Zaworek03/Line-Follower/KiCad/Dodatkowe elementy/1049/1049.step

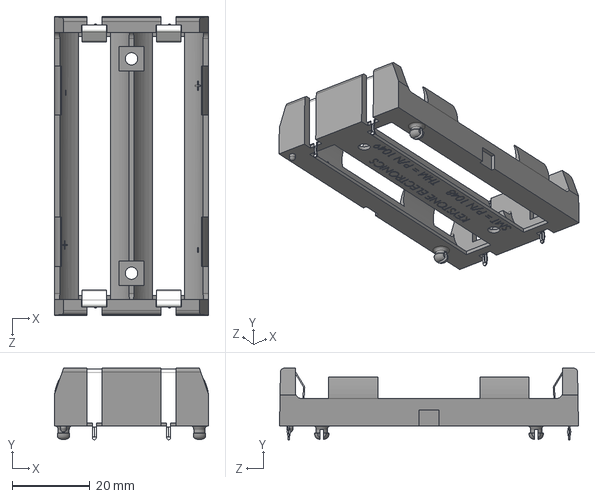
[picture p10: CAD file, 2025-11-26]
KiCad/Dodatkowe elementy/1049/1049.step
39.8 x 18.5 x 77.1 mm
