Zaworek03/Line-Follower/KiCad/Dodatkowe elementy/1N5819HW-7-F/1N5819HW-7-F.step

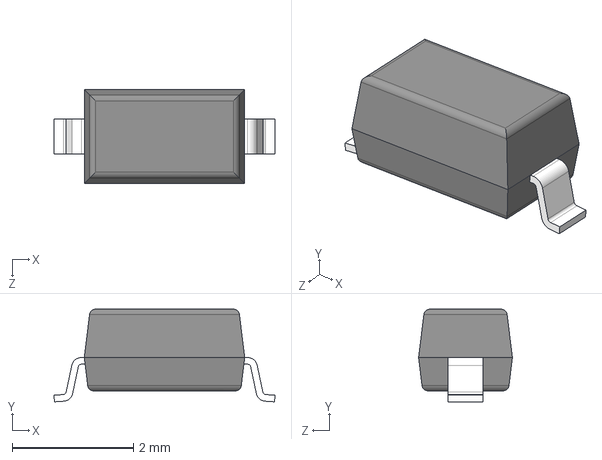
[picture p11: CAD file, 2025-11-26]
KiCad/Dodatkowe elementy/1N5819HW-7-F/1N5819HW-7-F.step
3.65 x 1.53 x 1.55 mm
