Zaworek03/Line-Follower/KiCad/Dodatkowe elementy/3362P-1-253LF-2/3362P-1-253LF.step

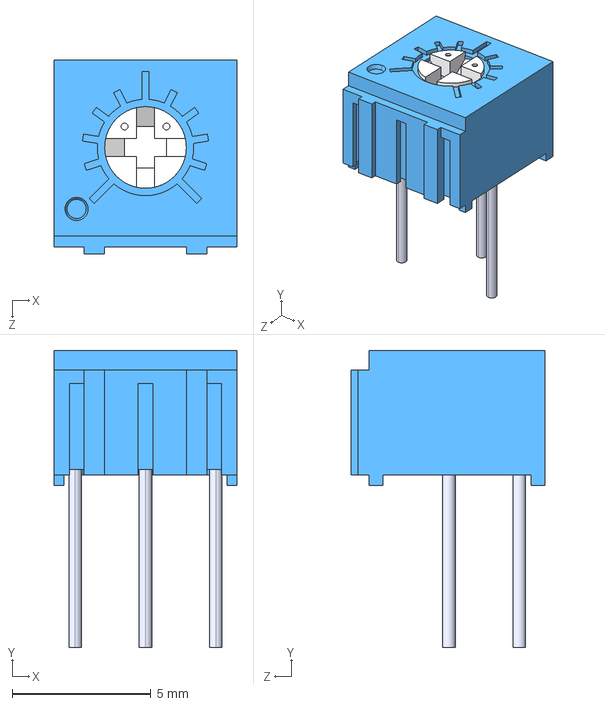
[picture p12: CAD file, 2025-11-26]
KiCad/Dodatkowe elementy/3362P-1-253LF-2/3362P-1-253LF.step
6.60 x 10.7 x 6.99 mm
