Zaworek03/Line-Follower/KiCad/Dodatkowe elementy/500SSP1S1M2REA/500SSP1S1M2REA.step

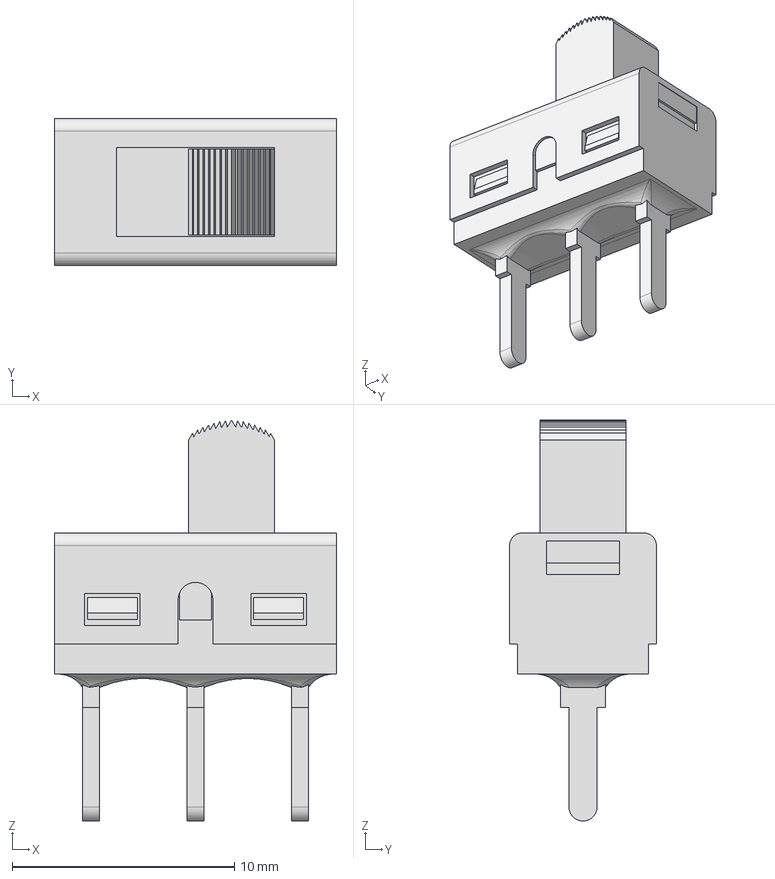
[picture p13: CAD file, 2025-11-26]
KiCad/Dodatkowe elementy/500SSP1S1M2REA/500SSP1S1M2REA.step
12.7 x 6.60 x 18.0 mm
