Zaworek03/Line-Follower/KiCad/Dodatkowe elementy/B2B-XH-A/B2B-XH-A.step

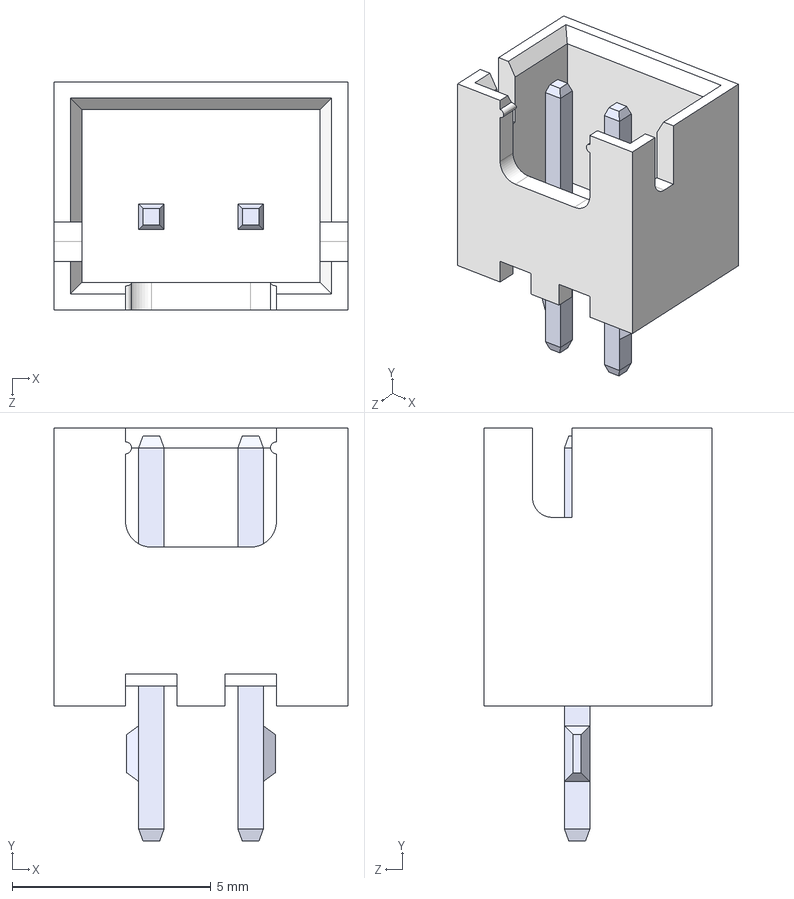
[picture p14: CAD file, 2025-11-26]
KiCad/Dodatkowe elementy/B2B-XH-A/B2B-XH-A.step
7.40 x 10.4 x 5.75 mm
