Zaworek03/Line-Follower/KiCad/Dodatkowe elementy/DM-OLED096-636/DM-OLED096-636.step

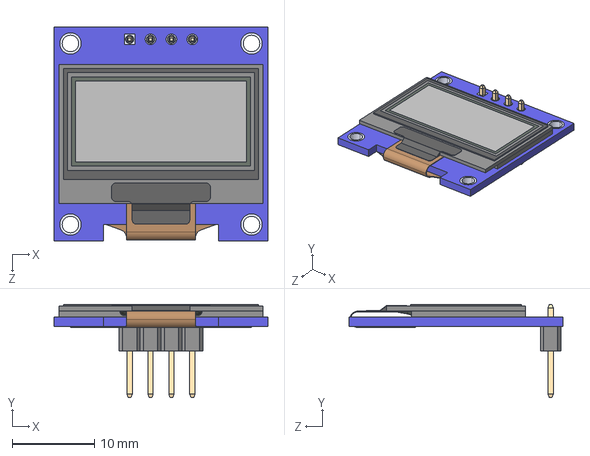
[picture p15: CAD file, 2025-11-26]
KiCad/Dodatkowe elementy/DM-OLED096-636/DM-OLED096-636.step
26.0 x 11.3 x 26.0 mm
DM-OLED096-636_Module
DM-OLED096-636_Panel
