Zaworek03/Line-Follower/KiCad/Dodatkowe elementy/ESP32-S3-WROOM-1U-N16R8/ESP32-S3-WROOM-1U-N16R8.step

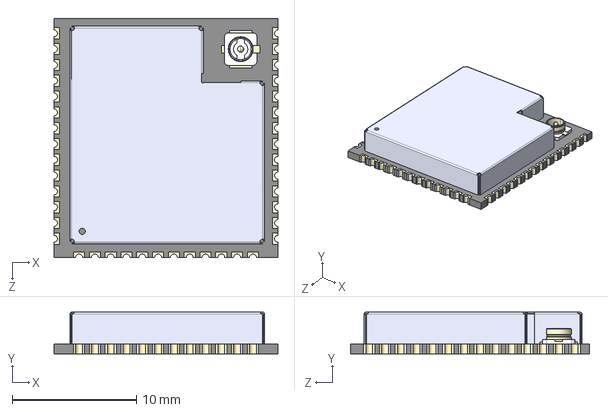
[picture p16: CAD file, 2025-11-26]
KiCad/Dodatkowe elementy/ESP32-S3-WROOM-1U-N16R8/ESP32-S3-WROOM-1U-N16R8.step
18.0 x 3.35 x 19.2 mm
