Zaworek03/Line-Follower/KiCad/Dodatkowe elementy/L298N/L298N.step

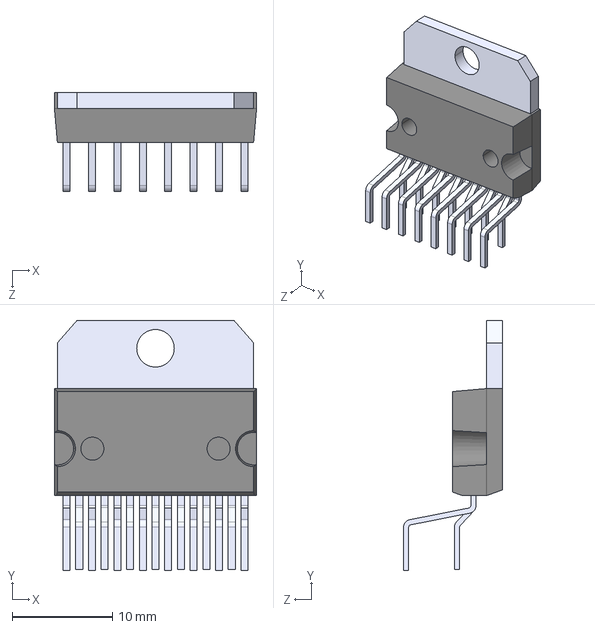
[picture p17: CAD file, 2025-11-26]
KiCad/Dodatkowe elementy/L298N/L298N.step
20.2 x 25.0 x 9.89 mm
