Zaworek03/Line-Follower/KiCad/Dodatkowe elementy/LESD5D5/LESD5D5.0CT1G.step

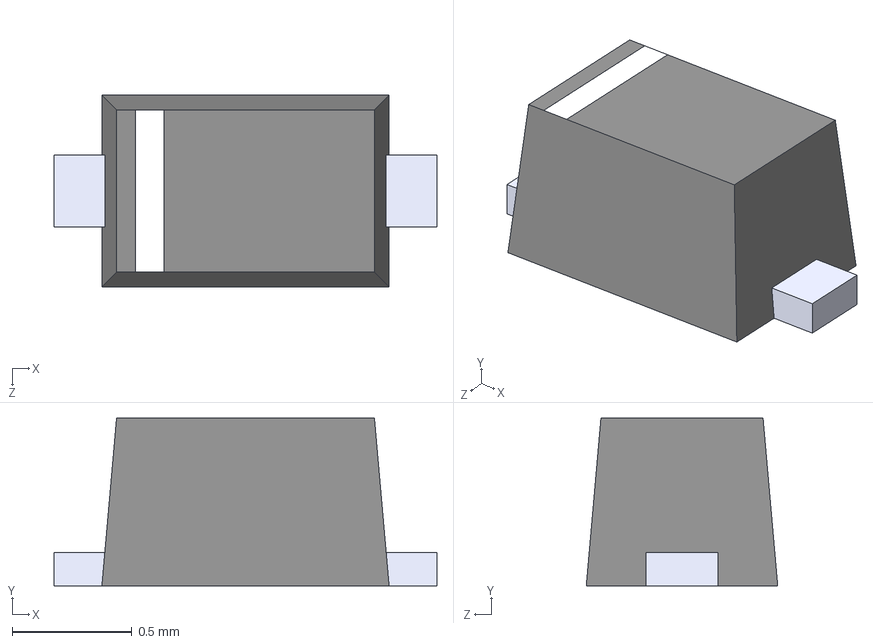
[picture p18: CAD file, 2025-11-26]
KiCad/Dodatkowe elementy/LESD5D5/LESD5D5.0CT1G.step
1.60 x 0.7 x 0.8 mm
