Zaworek03/Line-Follower/KiCad/Dodatkowe elementy/SS34/SS34.step

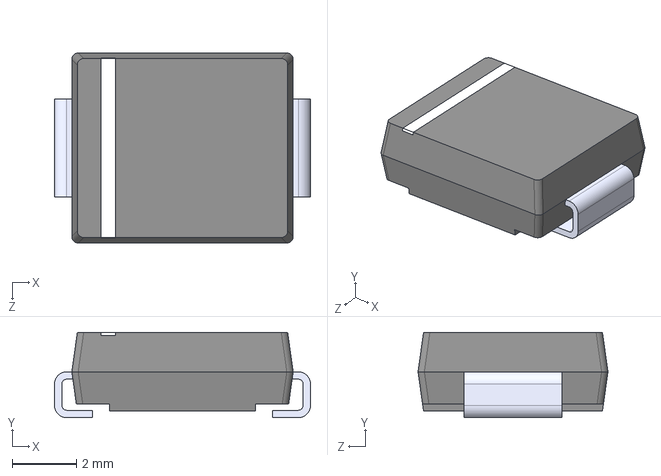
[picture p19: CAD file, 2025-11-26]
KiCad/Dodatkowe elementy/SS34/SS34.step
7.95 x 2.65 x 5.90 mm
