Zaworek03/Line-Follower/KiCad/Dodatkowe elementy/TB6612FNG/TB6612FNG.step

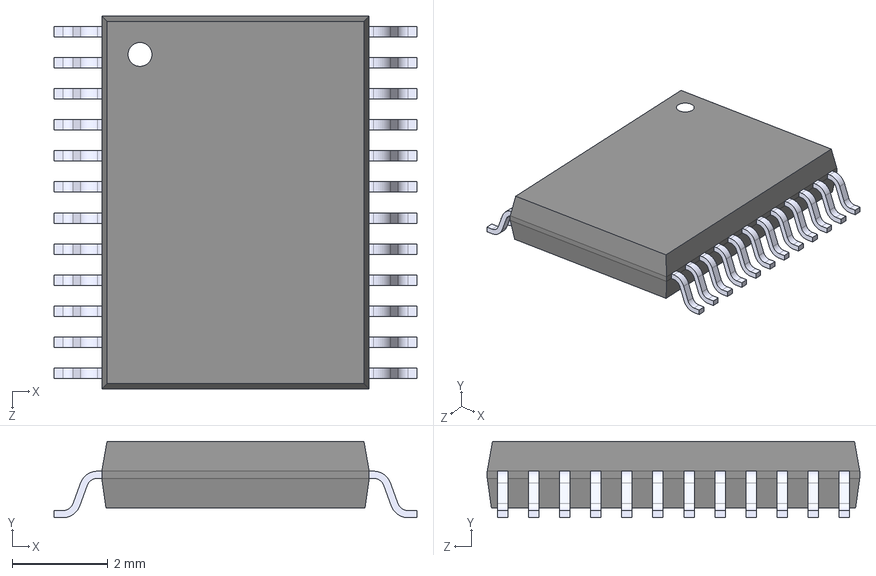
[picture p20: CAD file, 2025-11-26]
KiCad/Dodatkowe elementy/TB6612FNG/TB6612FNG.step
7.60 x 1.60 x 7.80 mm
