Zaworek03/Line-Follower/KiCad/Dodatkowe elementy/TCRT5000L/TCRT5000L.step

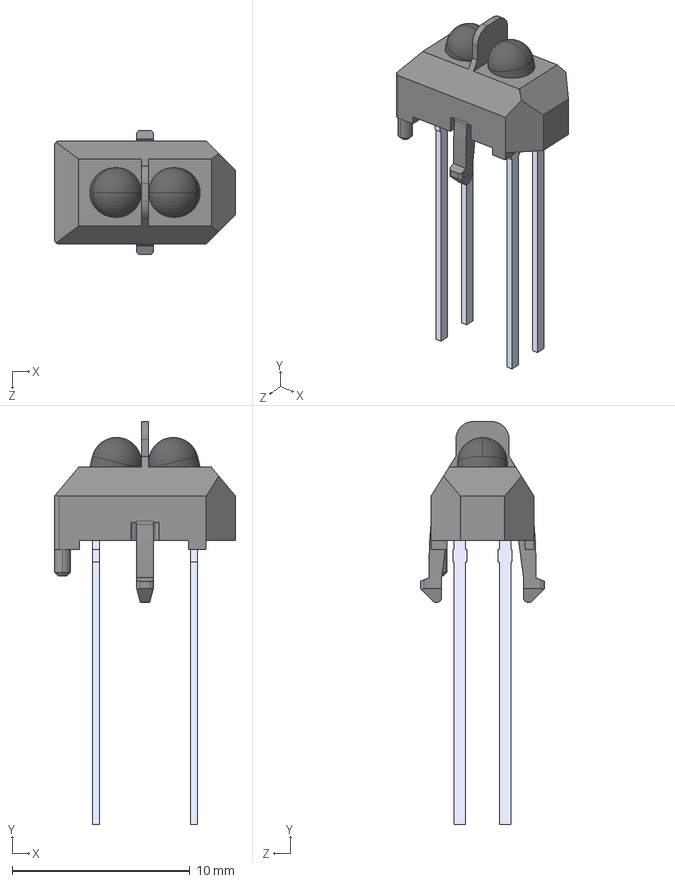
[picture p21: CAD file, 2025-11-26]
KiCad/Dodatkowe elementy/TCRT5000L/TCRT5000L.step
10.2 x 22.7 x 7.00 mm
