Zaworek03/Line-Follower/KiCad/Dodatkowe elementy/TS-1088-AR02016/TS-1088-AR02016.step

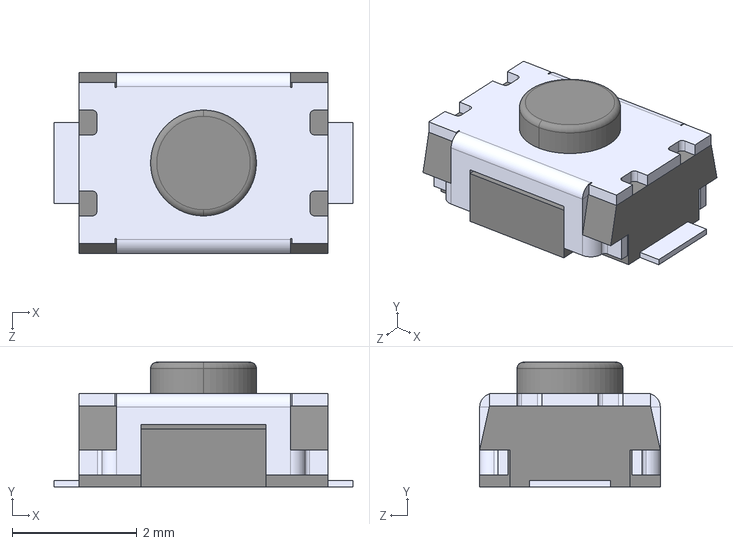
[picture p22: CAD file, 2025-11-26]
KiCad/Dodatkowe elementy/TS-1088-AR02016/TS-1088-AR02016.step
4.80 x 2.00 x 2.90 mm
