Zaworek03/Line-Follower/KiCad/Dodatkowe elementy/TS04-66-70-BK-260-SMT/TS04-66-70-BK-260-SMT.step

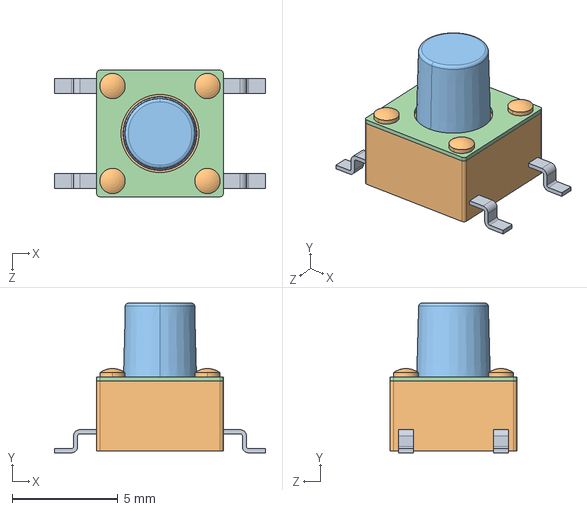
[picture p23: CAD file, 2025-11-26]
KiCad/Dodatkowe elementy/TS04-66-70-BK-260-SMT/TS04-66-70-BK-260-SMT.step
10.0 x 7.10 x 6.00 mm
