Zaworek03/Line-Follower/KiCad/gerber/Line follower-drl_map.dxf

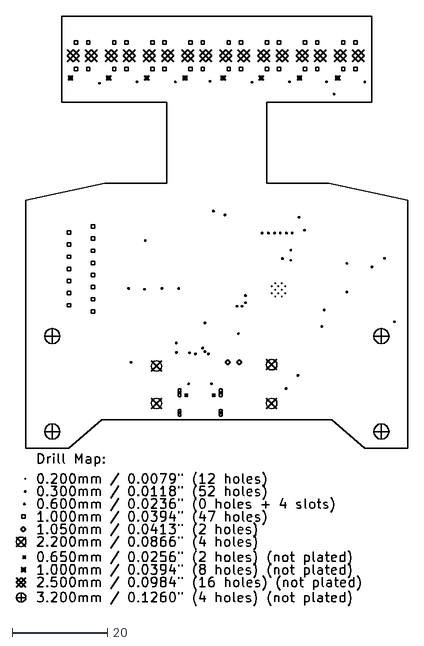
[picture p24: CAD file, 2025-11-26]
KiCad/gerber/Line follower-drl_map.dxf
82.0 x 123.5
