Zaworek03/Line-Follower/KiCad/Line follower.step

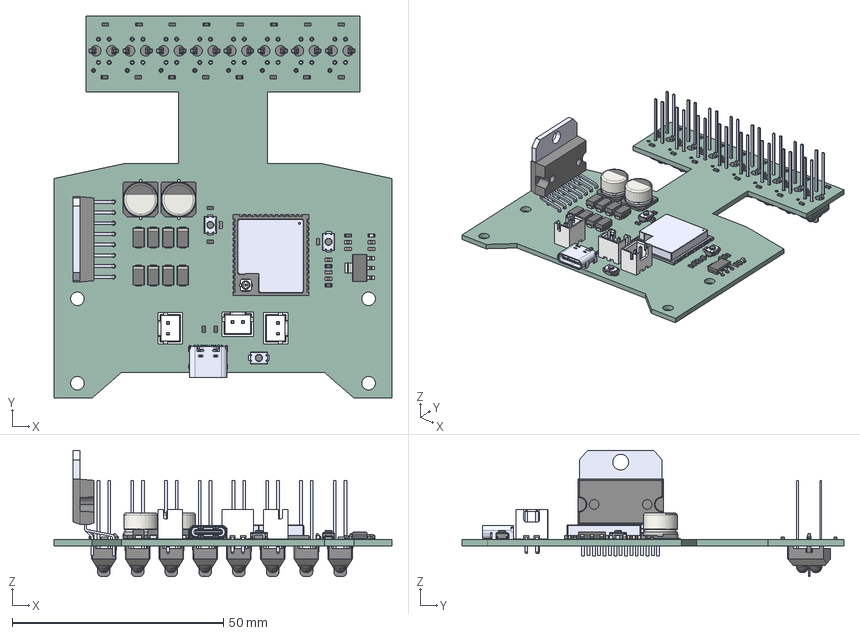
[picture p25: CAD file, 2025-11-26]
KiCad/Line follower.step
80.0 x 90.5 x 29.9 mm
L298N
R_0603_1608Metric x 23
ESP32-S3-WROOM-1U-N16R8
D_SMA x 8
BxB-XH-A_02 x 3
C_0603_1608Metric x 9
TS-1088-AR02016 x 3
CP_Elec_8x6.2 x 2
SOT-223
LED_0603_1608Metric
10155435-00011LF
TCRT5000L x 8
Line follower_PCB
