Zaworek03/Line-Follower/KiCad/Dodatkowe elementy/10155435-00011LF/10155435-00011LF.step

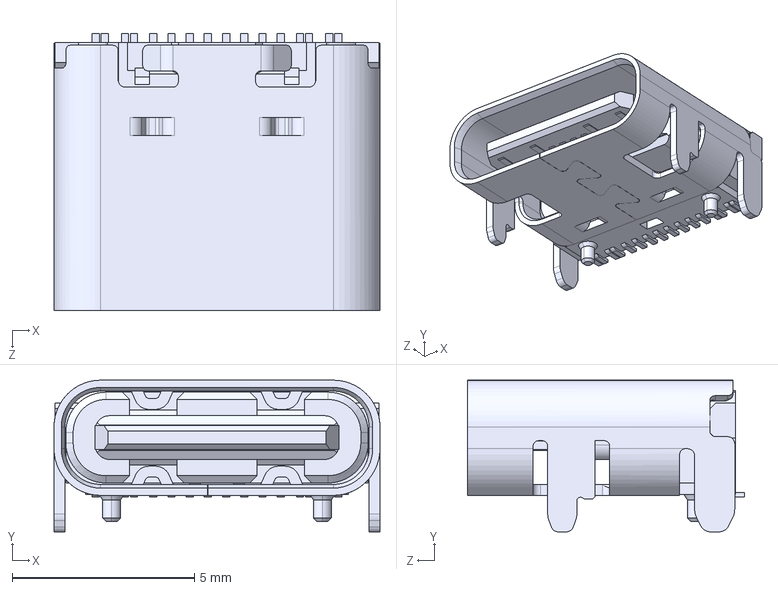
[picture p26: CAD file, 2025-11-26]
KiCad/Dodatkowe elementy/10155435-00011LF/10155435-00011LF.step
8.94 x 4.16 x 7.60 mm
