Zaworek03/Line-Follower/KiCad/Drukuj schemat.pdf

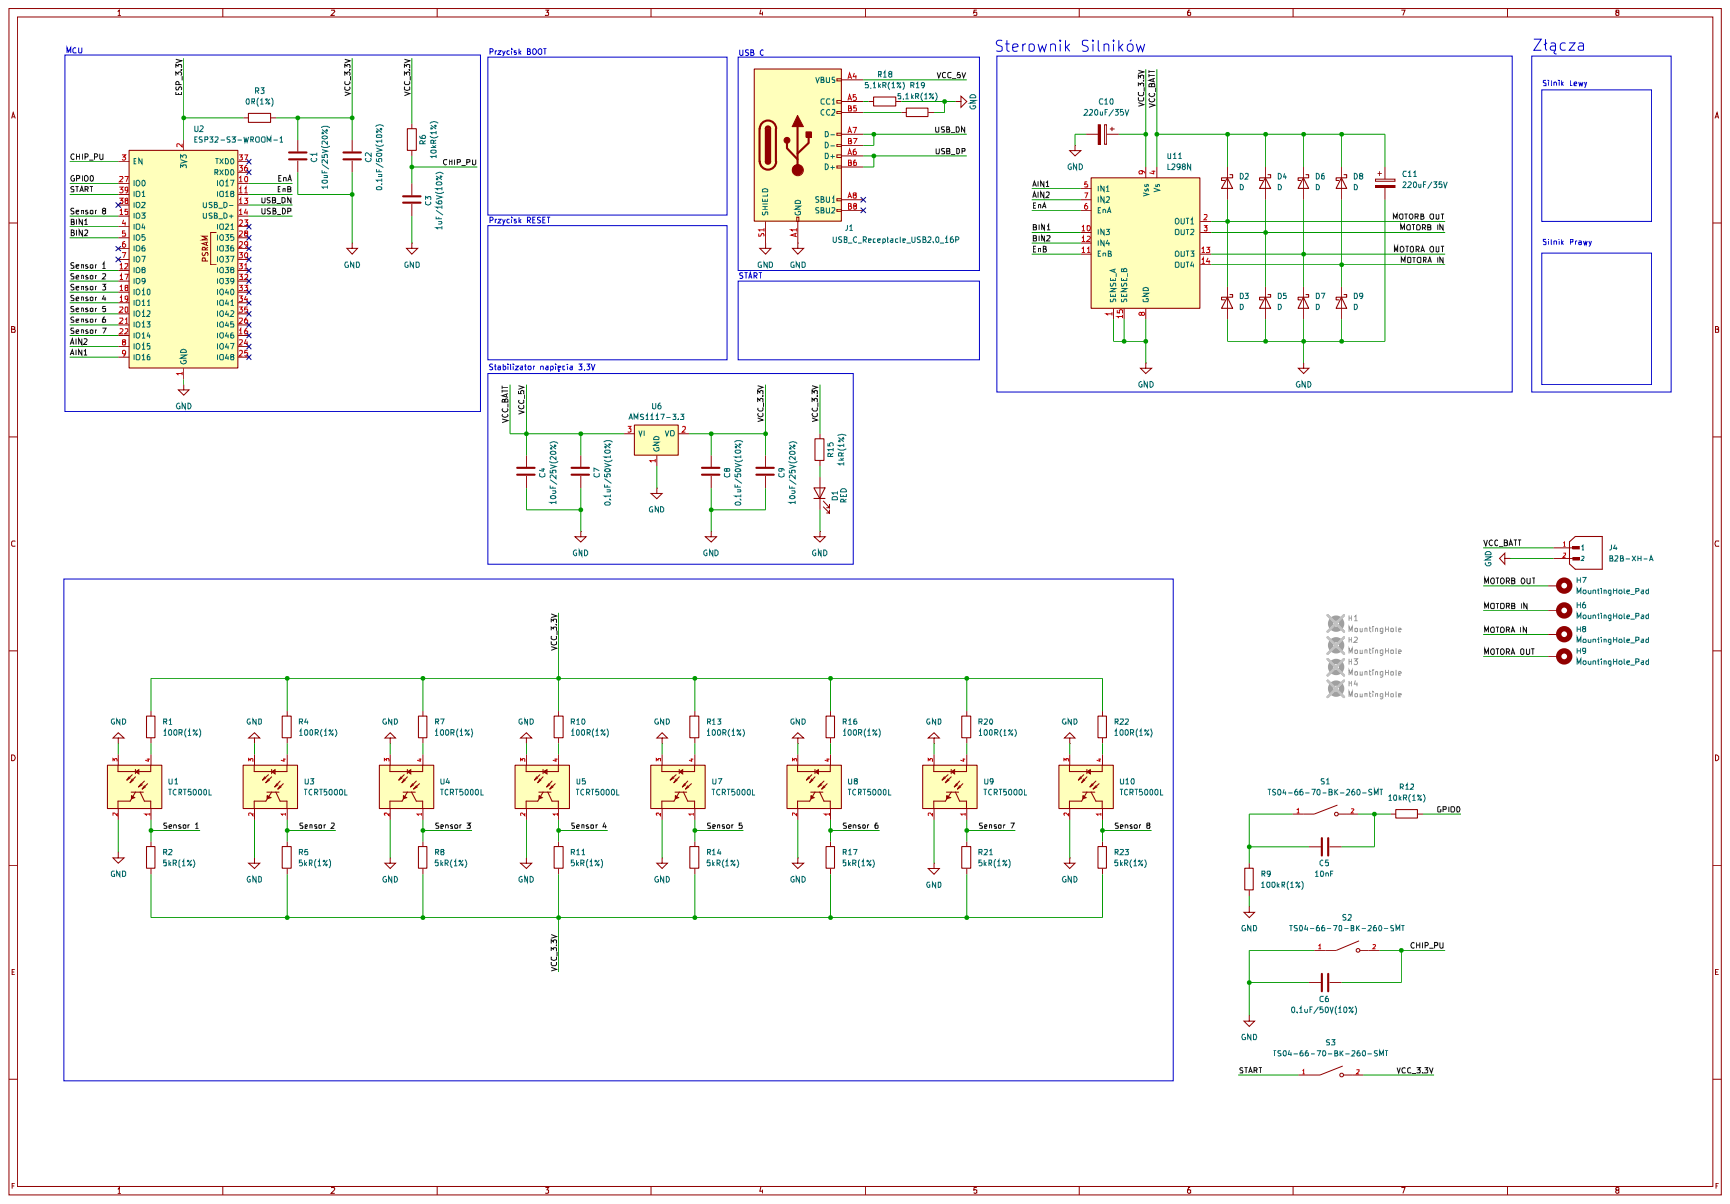
[picture p27: page 1]
