Zaworek03/Line-Follower/KiCad/Drukuj.pdf

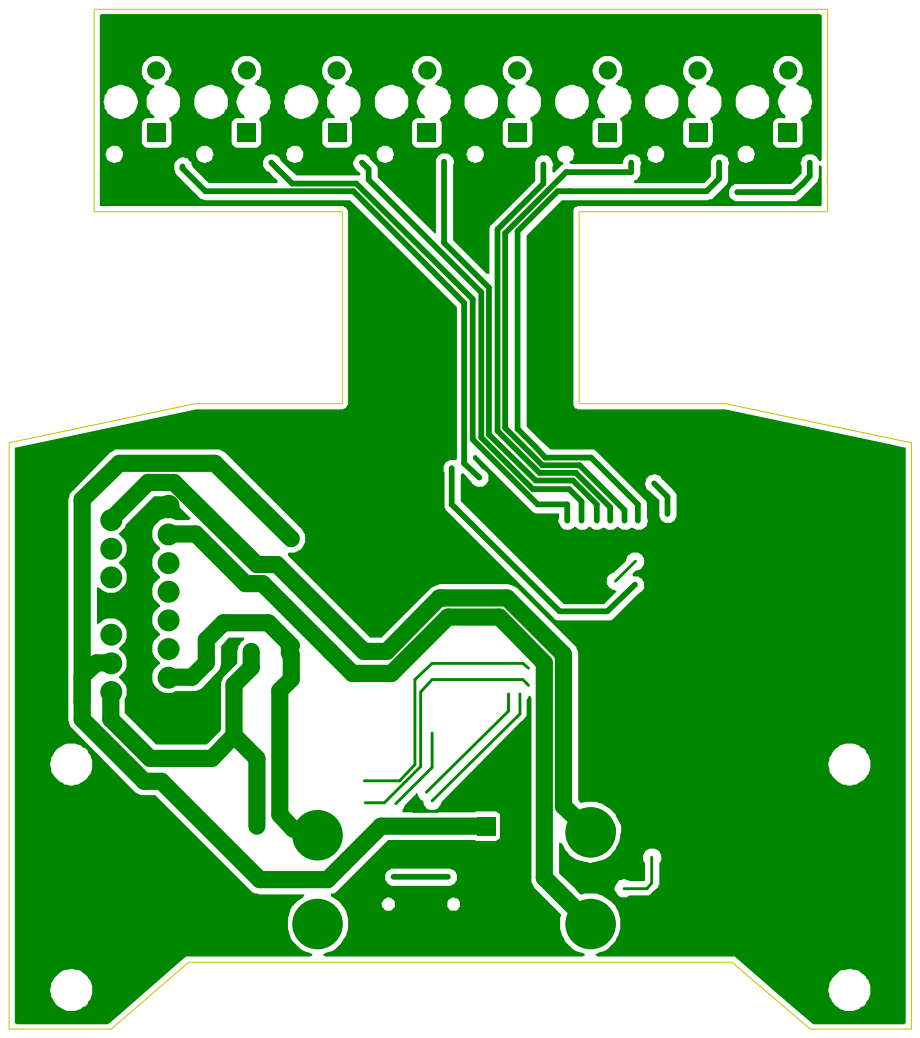
[picture p28: page 1]
