Zaworek03/Line-Follower/KiCad/Untitled.pdf

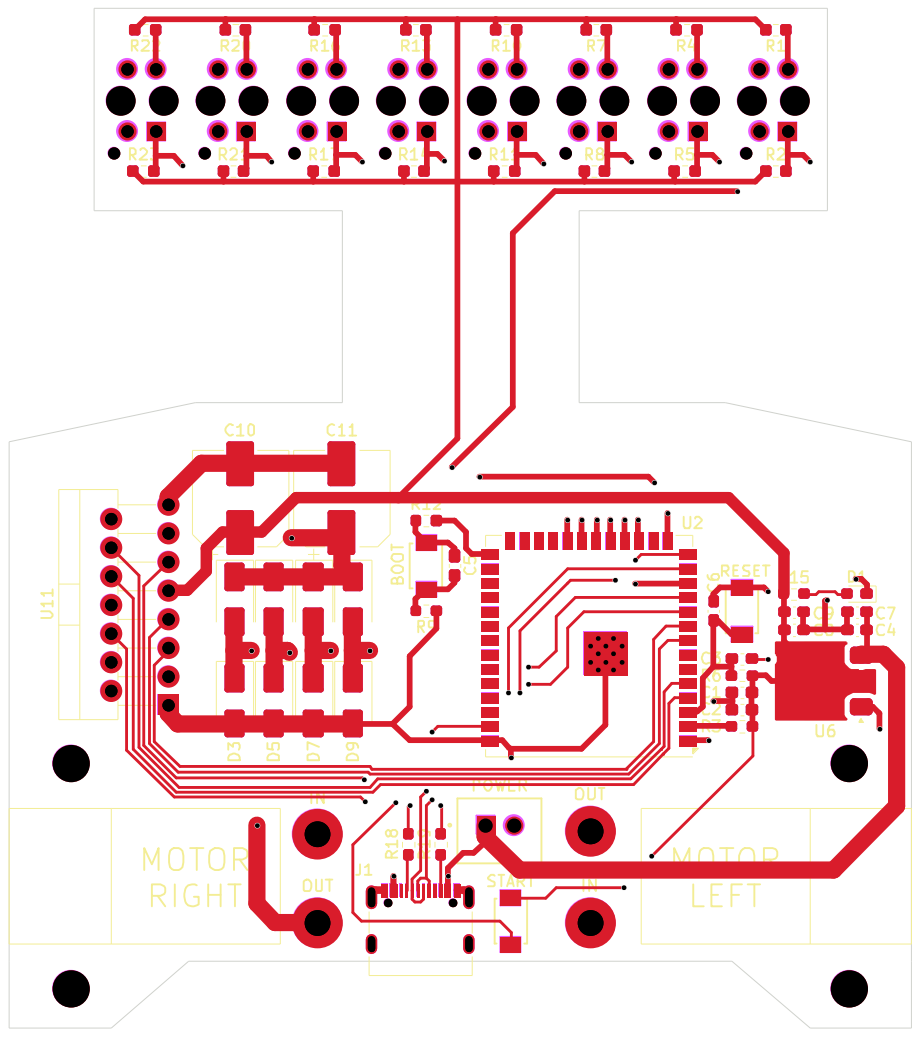
[picture p29: page 1]
