Zaworek03/Line-Follower/(list of files, drawings)

Other design files:
KiCad/freerouting.dsn
