Zaworek03/Line-Follower/KiCad/Line follower.kicad_pcb

## KiCad design KiCad/Line follower.kicad_pcb (2026-09-12)

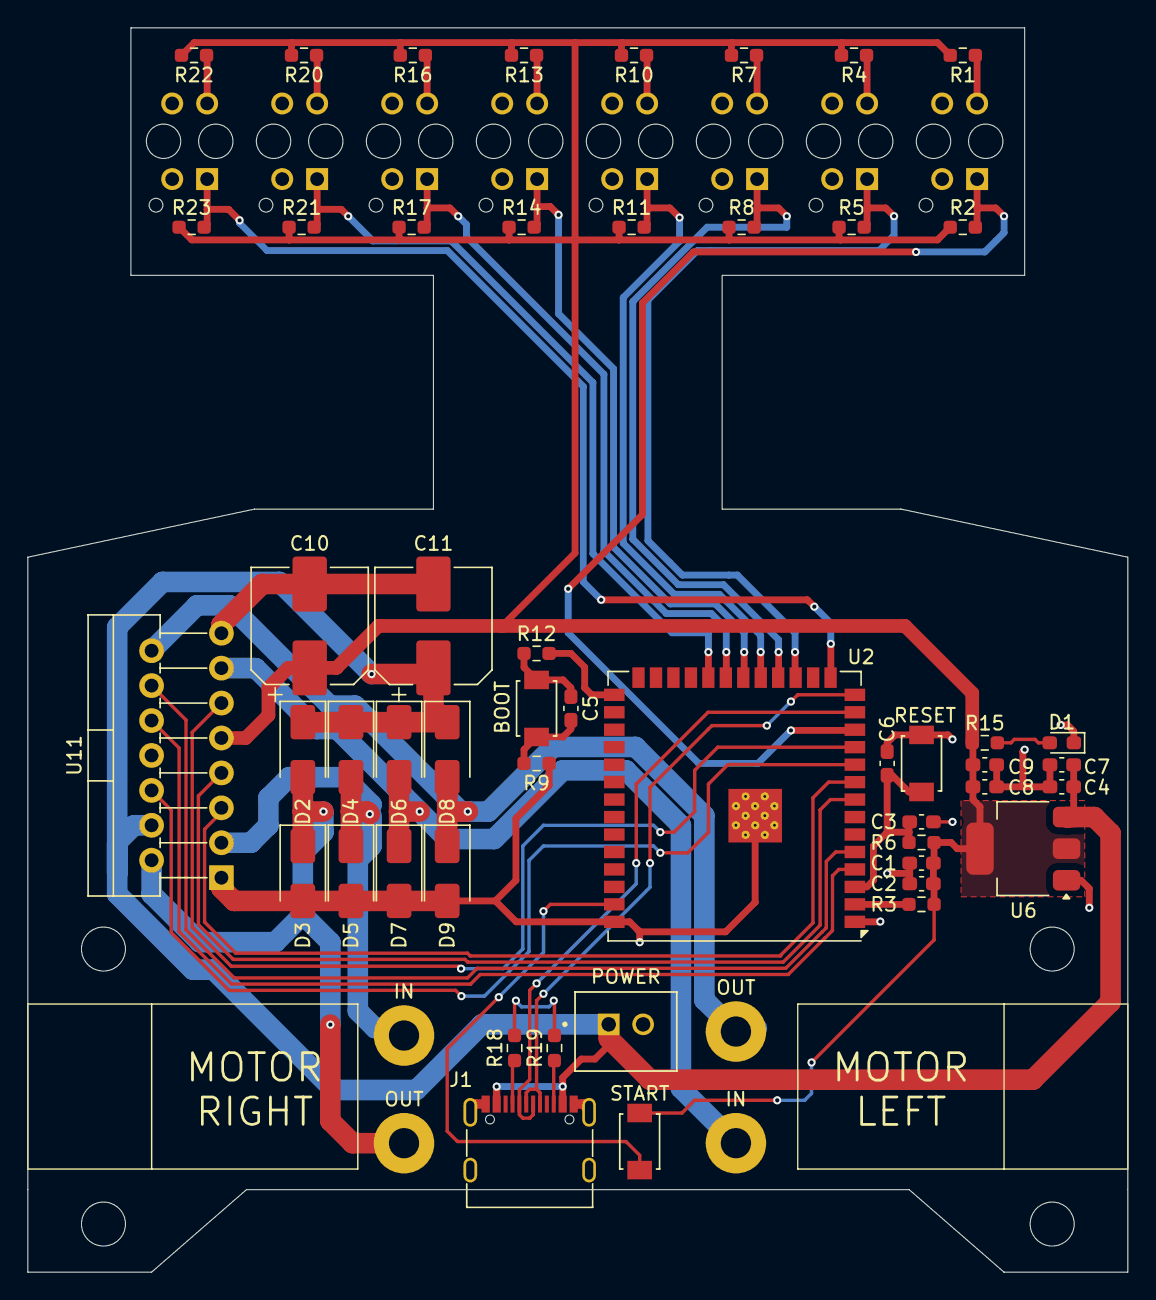
[picture p30: board Line follower.kicad_pcb from above]

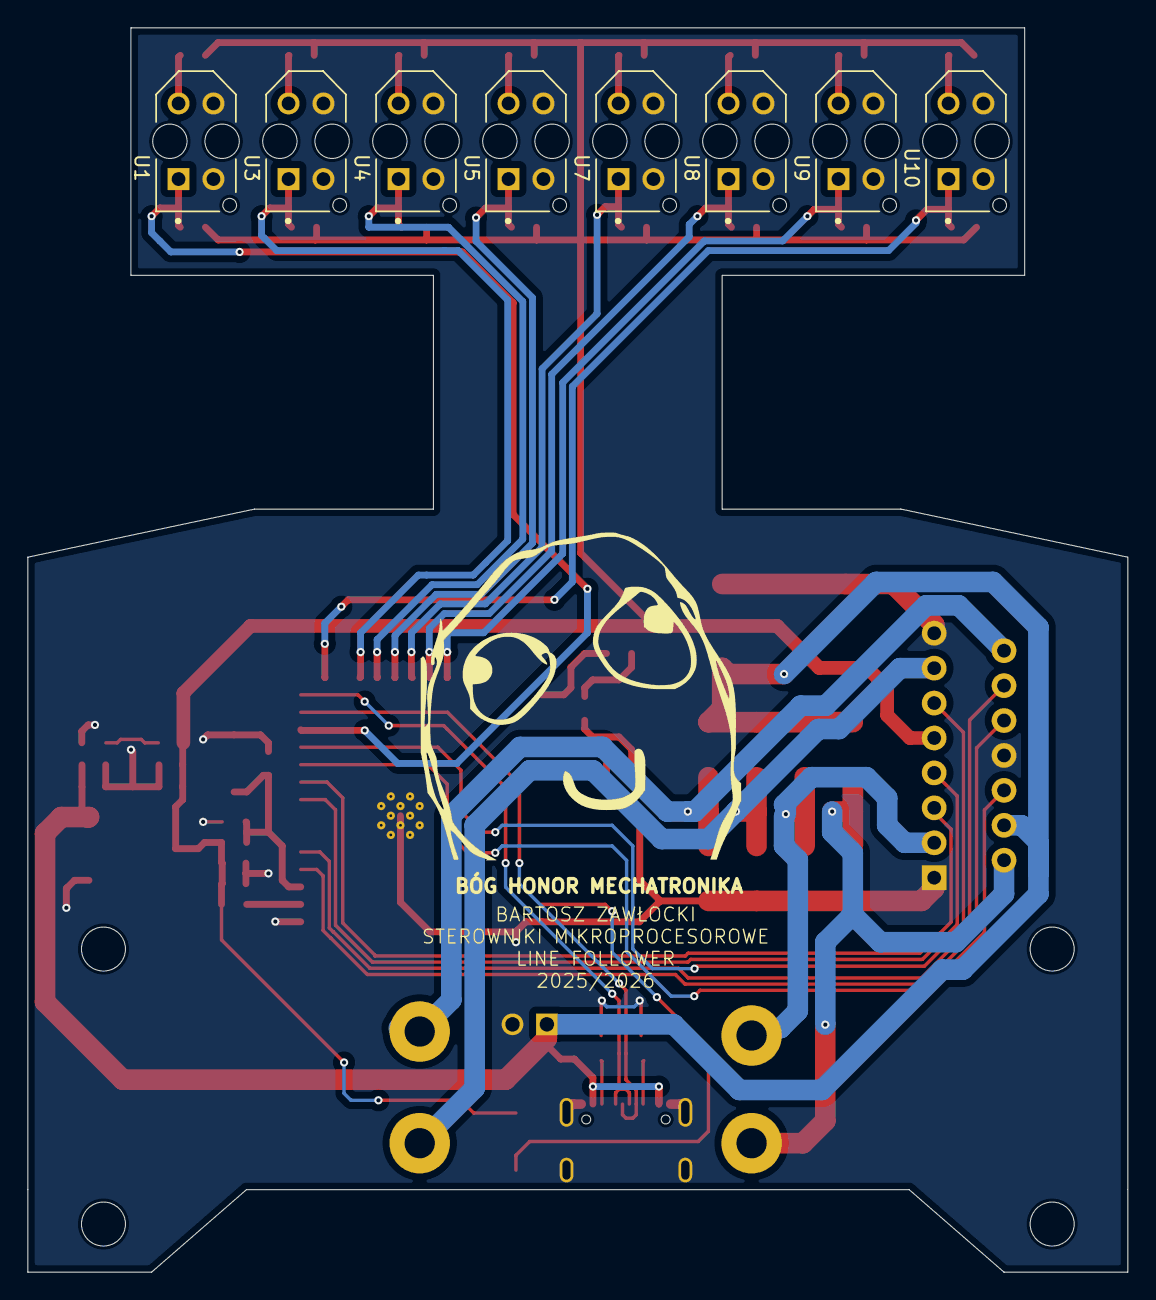
[picture p31: board Line follower.kicad_pcb from below]

Board: 2 copper layers, 80.0 x 90.5 mm, 67 parts (8 on the bottom side), 40 nets.

Parts:
BOOT: TS04-66-70-BK-260-SMT; SW_TS-1088-AR02016
C1, C4, C9: 10uF/25V(20%); C_0603_1608Metric_Pad1.08x0.95mm_HandSolder
C2, C6, C7, C8: 0.1uF/50V(10%); C_0603_1608Metric_Pad1.08x0.95mm_HandSolder
C3: 1uF/16V(10%); C_0603_1608Metric_Pad1.08x0.95mm_HandSolder
C5: 10nF; C_0603_1608Metric_Pad1.08x0.95mm_HandSolder
C10, C11: 220uF/35V; CP_Elec_8x6.2
D1: RED; LED_0603_1608Metric_Pad1.05x0.95mm_HandSolder
D2, D3, D4, D5, D6, D7, D8, D9: D; D_SMA
H1, H2, H3, H4: MountingHole; MountingHole_3.2mm_M3_DIN965
IN: MountingHole_Pad; MountingHole_2.2mm_M2_Pad
IN#2: MountingHole_Pad; MountingHole_2.2mm_M2_Pad
J1: USB_C_Receptacle_USB2.0_16P; USB_C_Receptacle_G-Switch_GT-USB-7010ASV
OUT: MountingHole_Pad; MountingHole_2.2mm_M2_Pad
OUT#2: MountingHole_Pad; MountingHole_2.2mm_M2_Pad
POWER: B2B-XH-A; JST_B2B-XH-A
R1, R4, R7, R10, R13, R16, R20, R22: 100R(1%); R_0603_1608Metric_Pad0.98x0.95mm_HandSolder
R2, R5, R8, R11, R14, R17, R21, R23: 5kR(1%); R_0603_1608Metric_Pad0.98x0.95mm_HandSolder
R3: 0R(1%); R_0603_1608Metric_Pad0.98x0.95mm_HandSolder
R6, R12: 10kR(1%); R_0603_1608Metric_Pad0.98x0.95mm_HandSolder
R9: 100kR(1%); R_0603_1608Metric_Pad0.98x0.95mm_HandSolder
R15: 1kR(1%); R_0603_1608Metric_Pad0.98x0.95mm_HandSolder
R18, R19: 5,1kR(1%); R_0603_1608Metric_Pad0.98x0.95mm_HandSolder
RESET: TS04-66-70-BK-260-SMT; SW_TS-1088-AR02016
START: TS04-66-70-BK-260-SMT; SW_TS-1088-AR02016
U1, U3, U4, U5, U7, U8, U9, U10: TCRT5000L; XDCR_TCRT5000L
U2: ESP32-S3-WROOM-1; ESP32-S3-WROOM-1U
U6: AMS1117-3.3; SOT-223-3_TabPin2
U11: L298N; TO-220-15_P2.54x5.08mm_StaggerOdd_Lead4.58mm_Vertical

Connections:
/AIN1: U2.9 (IO16), U11.5 (IN1)
/AIN2: U2.8 (IO15), U11.7 (IN2)
/BIN1: U2.4 (IO4), U11.10 (IN3)
/BIN2: U2.5 (IO5), U11.12 (IN4)
/CHIP_PU: C3.1, C6.1, R6.2, RESET.2, U2.3 (EN)
/ESP_3.3V: R3.1, U2.2 (3V3)
/EnA: U2.10 (IO17), U11.6 (EnA)
/EnB: U2.11 (IO18), U11.11 (EnB)
/GPIO0: R12.2, U2.27 (IO0)
/MOTORA IN: D8.2 (A), D9.1 (K), OUT.1, U11.14 (OUT4)
/MOTORA OUT: D6.2 (A), D7.1 (K), IN#2.1, U11.13 (OUT3)
/MOTORB IN: D4.2 (A), D5.1 (K), IN.1, U11.3 (OUT2)
/MOTORB OUT: D2.2 (A), D3.1 (K), OUT#2.1, U11.2 (OUT1)
/START: START.1, U2.39 (IO1)
/Sensor 1: R2.2, U1.1, U2.12 (IO8)
/Sensor 2: R5.2, U2.17 (IO9), U3.1
/Sensor 3: R8.2, U2.18 (IO10), U4.1
/Sensor 4: R11.2, U2.19 (IO11), U5.1
/Sensor 5: R14.2, U2.20 (IO12), U7.1
/Sensor 6: R17.2, U2.21 (IO13), U8.1
/Sensor 7: R21.2, U2.22 (IO14), U9.1
/Sensor 8: R23.2, U2.15 (IO3), U10.1
/USB_DN: J1.A7 (D-), J1.B7 (D-), U2.13 (USB_D-)
/USB_DP: J1.A6 (D+), J1.B6 (D+), U2.14 (USB_D+)
/VCC_3.3V: C1.1, C2.1, C8.1, C9.1, C10.1, R1.2, R2.1, R3.2, R4.2, R5.1, R6.1, R7.2, R8.1, R10.2, R11.1, R13.2, R14.1, R15.1, R16.2, R17.1, R20.2, R21.1, R22.2, R23.1, START.2, U6.2 (VO), U11.9 (Vss)
/VCC_5V: C4.1, C7.1, C11.1, D2.1 (K), D4.1 (K), D6.1 (K), D8.1 (K), J1.A4 (VBUS), J1.A9 (VBUS), J1.B4 (VBUS), J1.B9 (VBUS), POWER.1, U6.3 (VI), U11.4 (Vs)
GND: C1.2, C2.2, C3.2, C4.2, C6.2, C7.2, C8.2, C9.2, C10.2, C11.2, D1.1 (K), D3.2 (A), D5.2 (A), D7.2 (A), D9.2 (A), J1.A1 (GND), J1.A12 (GND), J1.B1 (GND), J1.B12 (GND), J1.S1 (SHIELD), POWER.2, R9.1, R18.2, R19.2, RESET.1, U1.2, U1.3, U2.1 (GND), U2.40 (GND), U2.41 (GND), U3.2, U3.3, U4.2, U4.3, U5.2, U5.3, U6.1 (GND), U7.2, U7.3, U8.2, U8.3, U9.2, U9.3, U10.2, U10.3, U11.1 (SENSE_A), U11.8 (GND), U11.15 (SENSE_B)
unnamed: BOOT.2, C5.1, R12.1
unnamed: BOOT.1, C5.2, R9.2
unnamed: D1.2 (A), R15.2
unnamed: J1.A5 (CC1), R18.1
unnamed: J1.B5 (CC2), R19.1
unnamed: R1.1, U1.4
unnamed: R4.1, U3.4
unnamed: R7.1, U4.4
unnamed: R10.1, U5.4
unnamed: R13.1, U7.4
unnamed: R16.1, U8.4
unnamed: R20.1, U9.4
unnamed: R22.1, U10.4
