Zaworek03/Line-Follower/(commit log)

2025-11-26 Dodanie plików do projektu
    Dodałem wszystkie pliki z KiCad, Datasheet oraz dokumentacji technicznej
    [10155435-00011LF.step, 1049.step, 1N5819HW-7-F.step, 3362P-1-253LF.step, 500SSP1S1M2REA.step, B2B-XH-A.step, DM-OLED096-636.step, ESP32-S3-WROOM-1U-N16R8.step]
2026-09-12 Dodanie brakujacych plikow
    [Line follower.kicad_pcb]
